hazptr/openrb-pico-hw/kicad/reference/render/openrb_rev0.2_bottom.png

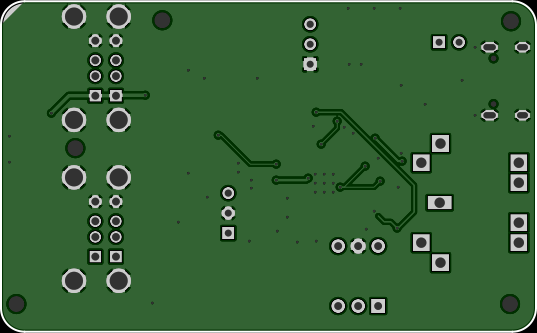
kicad/reference/render/openrb_rev0.2_bottom.png
