hazptr/openrb-pico-hw/kicad/reference/render/openrb_rev0.2_top.png

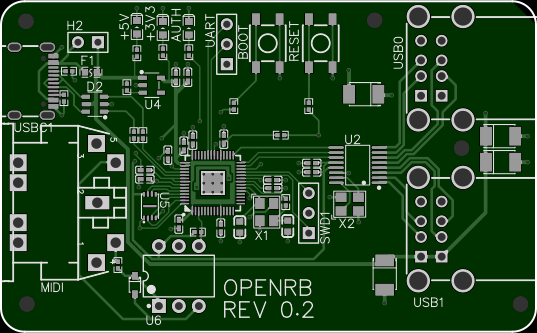
kicad/reference/render/openrb_rev0.2_top.png
