hazptr/openrb-pico-hw/recovered-artifacts/openrb_rev0.2_BOM.csv

ID | Name | Designator | Footprint | Quantity | Manufacturer Part | Manufacturer | Supplier | Supplier Part | Price | Contributor | 3DModel | link | JLCPCB Part Class | Package Display | image | subpart_no
1 | LED-0603_R | +3V3,+5V,AUTH | LED0603_RED | 3 | 19-217/R6C-AL1M2VY/3T | EVERLIGHT(台湾亿光) | LCSC | C72044 |  | LCEDA_01 | LED0603_Red
2 | PTS647SM38SMTR2LFS | BOOT,RESET | KEY-SMD_4P-L4.5-W4.5-P3.00-LS6.5-TL | 2 | PTS647SM38SMTR2LFS | C&K | LCSC | C2689502 |  | LCSC | KEY-SMD_4P-L4.5-W4.5-P3.00-LS6.5-TL | https://item.szlcsc.com/532641.html?ref=editor&logined=true | Extended Part
3 | 10uF | C1,C2 | C0402 | 2 | GRM155R61A106ME44D | muRata(村田) | LCSC | C77000 |  | lcsc | C0402_L1.0-W0.5-H0.5 | https://item.szlcsc.com/15869.html | Extended Part
4 | 100nF | C3,C4,C5,C6,C8,C9,C10,C11 | C0402 | 8 | CL05B104KB54PNC | SAMSUNG(三星) | LCSC | C307331 |  | LCSC | C0402_L1.0-W0.5-H0.5 | https://item.szlcsc.com/15869.html | Basic Part
5 | 1uF | C7,C18 | C0402 | 2 |  |  | LCSC | C107372 |  | lcsc | C0402_L1.0-W0.5-H0.5 | https://item.szlcsc.com/15869.html | Extended Part | No
6 | 100uF | C12,C13,C14,C17 | CASE-B_3528 | 4 | TAJB107K006RNJ | Kyocera AVX | LCSC | C16133 |  | lcsc | CASE-B_L3.5-W2.8-H1.9 | https://img.jlc.com/pdf/applyPasteComponent/2021-05-29/507681S/b3196547ade04cd291a1b09ea1ee2ece/C7199_22UF.PDF | Basic Part
7 | 15pF | C15,C16 | C0603 | 2 | CL10C150JB8NNNC |  | LCSC | C1644 |  | lcsc | C0603_L1.6-W0.8-H0.8 | https://item.szlcsc.com/362304.html | Extended Part | No
8 | 1uF | C19,C20 | C0402 | 2 |  |  | LCSC | C107372 |  | lcsc | C0402_L1.0-W0.5-H0.5 | https://item.szlcsc.com/15869.html |  | No
9 | 1N4148WS_C402214 | D1 | SOD-323_L1.8-W1.3-LS2.5-RD | 1 | 1N4148WS | LGE(鲁光) | LCSC | C402214 |  | LCSC | SOD-323_L1.7-W1.3-H1.1-LS2.5 | https://item.szlcsc.com/295156.html | Extended Part
10 | USBLC6-2SC6_C2827654 | D2 | SOT-23-6_L2.9-W1.6-P0.95-LS2.8-BL | 1 | USBLC6-2SC6 | TECH PUBLIC(台舟) | LCSC | C2827654 |  | LCSC | SOT-23-6_L2.9-W1.6-H1.5-LS2.8-P0.95 | https://item.szlcsc.com/169042.html | Extended Part
11 | ASMD0603-020 | F1 | F0603 | 1 | ASMD0603-020 | JDTfuse(集电通) | LCSC | C135321 |  | LCSC | F0603_L1.7-W0.9-H0.7 | https://item.szlcsc.com/208133.html | Extended Part
12 | HDR-F-2.54_1x2 | H2 | HDR-F-2.54_1X2 | 1 |  |  | LCSC | C49661 |  | LCEDA_Lib | HDR-F-2.54_1x2
13 | MIDIJACK | MIDI | CP-2350 | 1 |  |  |  |  |  | Adafruit |  |  |  |  |  | 3
14 | 5.1kΩ | R1 | R0402 | 1 |  |  | LCSC |  |  | lcsc | R0402_L1.0-W0.5-H0.5 | https://item.szlcsc.com/323315.html | Extended Part
15 | 220Ω | R2 | R0402 | 1 |  |  | LCSC | C25091 |  | lcsc | R0402_L1.0-W0.5-H0.5 | https://item.szlcsc.com/323315.html | Extended Part | No
16 | 5.1kΩ | R3 | R0402 | 1 |  |  |  |  |  | lcsc | R0402_L1.0-W0.5-H0.5 | https://item.szlcsc.com/323315.html | Extended Part
17 | 470Ω | R4 | R0402 | 1 | RC0402JR-07470RL | YAGEO(国巨) | LCSC | C114949 |  | lcsc | R0402_L1.0-W0.5-H0.5 | https://item.szlcsc.com/323315.html | Extended Part
18 | 470Ω | R6,R8 | R0402 | 2 |  |  |  |  |  | LCEDA_Lib | R0402_L1.0-W0.5-H0.5 | https://item.szlcsc.com/323315.html |  | No
19 | 10kΩ | R9 | R0402 | 1 |  |  |  |  |  | lcsc | R0402_L1.0-W0.5-H0.5 | https://item.szlcsc.com/323315.html | Extended Part | No
20 | 1kΩ | R10 | R0402 | 1 | RC0402JR-071KL | YAGEO(国巨) | LCSC | C105637 |  | lcsc | R0402_L1.0-W0.5-H0.5 | https://item.szlcsc.com/323315.html | Extended Part
21 | 1kΩ | R7,R11,R12 | R0402 | 3 |  |  |  |  |  | LCEDA_Lib | R0402_L1.0-W0.5-H0.5 | https://item.szlcsc.com/323315.html
22 | 10kΩ | R13 | R0402 | 1 |  |  |  |  |  | LCEDA_Lib | R0402_L1.0-W0.5-H0.5 | https://item.szlcsc.com/323315.html
23 | 22Ω | R14,R15 | R0402 | 2 |  |  |  |  |  | LCEDA_Lib | R0402_L1.0-W0.5-H0.5 | https://item.szlcsc.com/323315.html
24 | HDR-F-2.54_1x3 | SWD1,UART | HDR-F-2.54_1X3 | 2 |  |  | LCSC | C146690 |  | LCEDA_Lib | HDR-F-2.54_1x3 | https://www.cjt.com/Upload/A2541.pdf
25 | RP2040 | U1 | LQFN-56_L7.0-W7.0-P0.4-EP | 1 | RP2040 | Raspberry Pi(树莓派) | LCSC | C2040 |  | LCSC | LQFN-56_L7.0-W7.0-P0.4-EP | https://atta.szlcsc.com/upload/public/pdf/source/20210621/C2040_96F425825606B7957D87DD32E2512CA9.pdf | Extended Part
26 | CH334R | U2 | QSOP-16_L4.9-W3.9-P0.64-LS6.0-BL | 1 | CH334R | WCH(南京沁恒) | LCSC | C4154405 |  | lcsc | QSOP-16_L4.9-W3.9-H1.6-LS6.0-P0.64 | https://item.szlcsc.com/216411.html | Extended Part
27 | RT9080-33GJ5 | U4 | TSOT-23-5_L2.9-W1.6-P0.95-LS2.8-BL | 1 | RT9080-33GJ5 | RICHTEK(立锜) | LCSC | C841192 |  | LCSC | TSOT-23-5_L2.9-W1.6-H1.00-LS2.8-P0.95 | https://item.szlcsc.com/233411.html | Extended Part
28 | W25Q16JVUXIQ | U5 | USON-8_L3.0-W2.0-P0.50-BL-EP | 1 | W25Q16JVUXIQ | WINBOND(华邦) | LCSC | C2843335 |  | lcsc | USON-8_L2-W3-H0.6X0.5P | https://item.szlcsc.com/355847.html | Extended Part
29 | H11L1 | U6 | DIP-6_L8.5-W6.4-P2.54-LS7.6-BL | 1 | H11L1 | EVERLIGHT(亿光) | LCSC | C78588 |  | lcsc | DIP-6_L7.3-W6.5-H3.5-LS7.62-P2.54 | https://item.szlcsc.com/195665.html | Extended Part
30 | UB1112C-8FDE-4F | USB0,USB1 | USB-A-TH_UB1112C-8FDE-4F | 2 | UB1112C-8FDE-4F | FOXCONN(富士康) | LCSC | C2761534 |  | LCSC | USB-A-TH_UB1112C-8FDE-4F | https://item.szlcsc.com/2885963.html | Extended Part
31 | TYPE-C-31-M-12 | USBC1 | USB-C_SMD-TYPE-C-31-M-12 | 1 | TYPE-C-31-M-12 | 韩国韩荣 | LCSC | C165948 |  | LCSC | USB-C_SMD-TYPE-C-31-M-12 | https://so.szlcsc.com/global.html?c=&k=C165948 | Extended Part
32 | 12MHz | X1,X2 | OSC-SMD_4P-L3.2-W2.5-BL | 2 | X322512MSB4SI | YXC(扬兴晶振) | LCSC | C9002 |  | lcsc | OSC-SMD_4P-L3.2-W2.5-H1.0 | https://item.szlcsc.com/15866.html | Basic Part
