hazptr/openrb-pico-hw/kicad/openrb/openrb_schematic.pdf

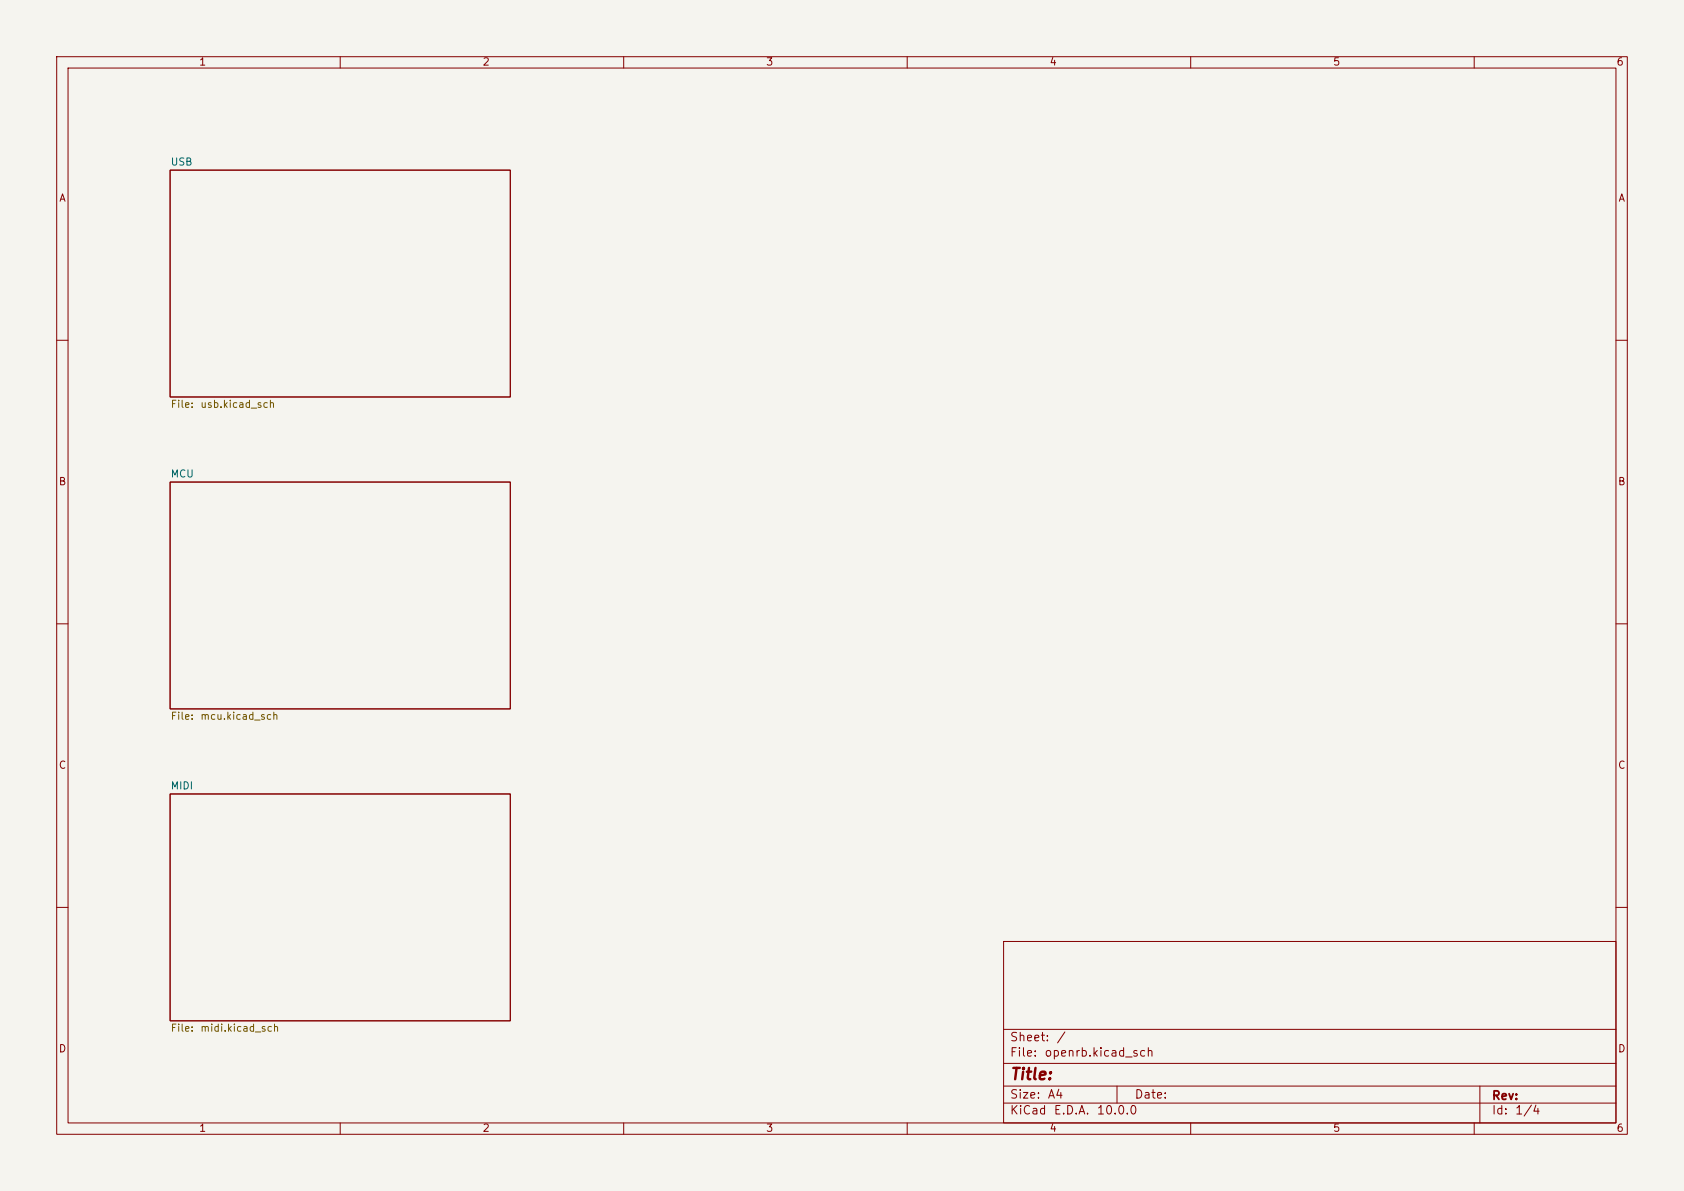
[picture p3: page 1]

File: mcu.kicad_sch MIDI File: midi.kicad_sch

Size: A4 | Rev:
KiCad E.D.A. 10.0.0 | Id: 1/4

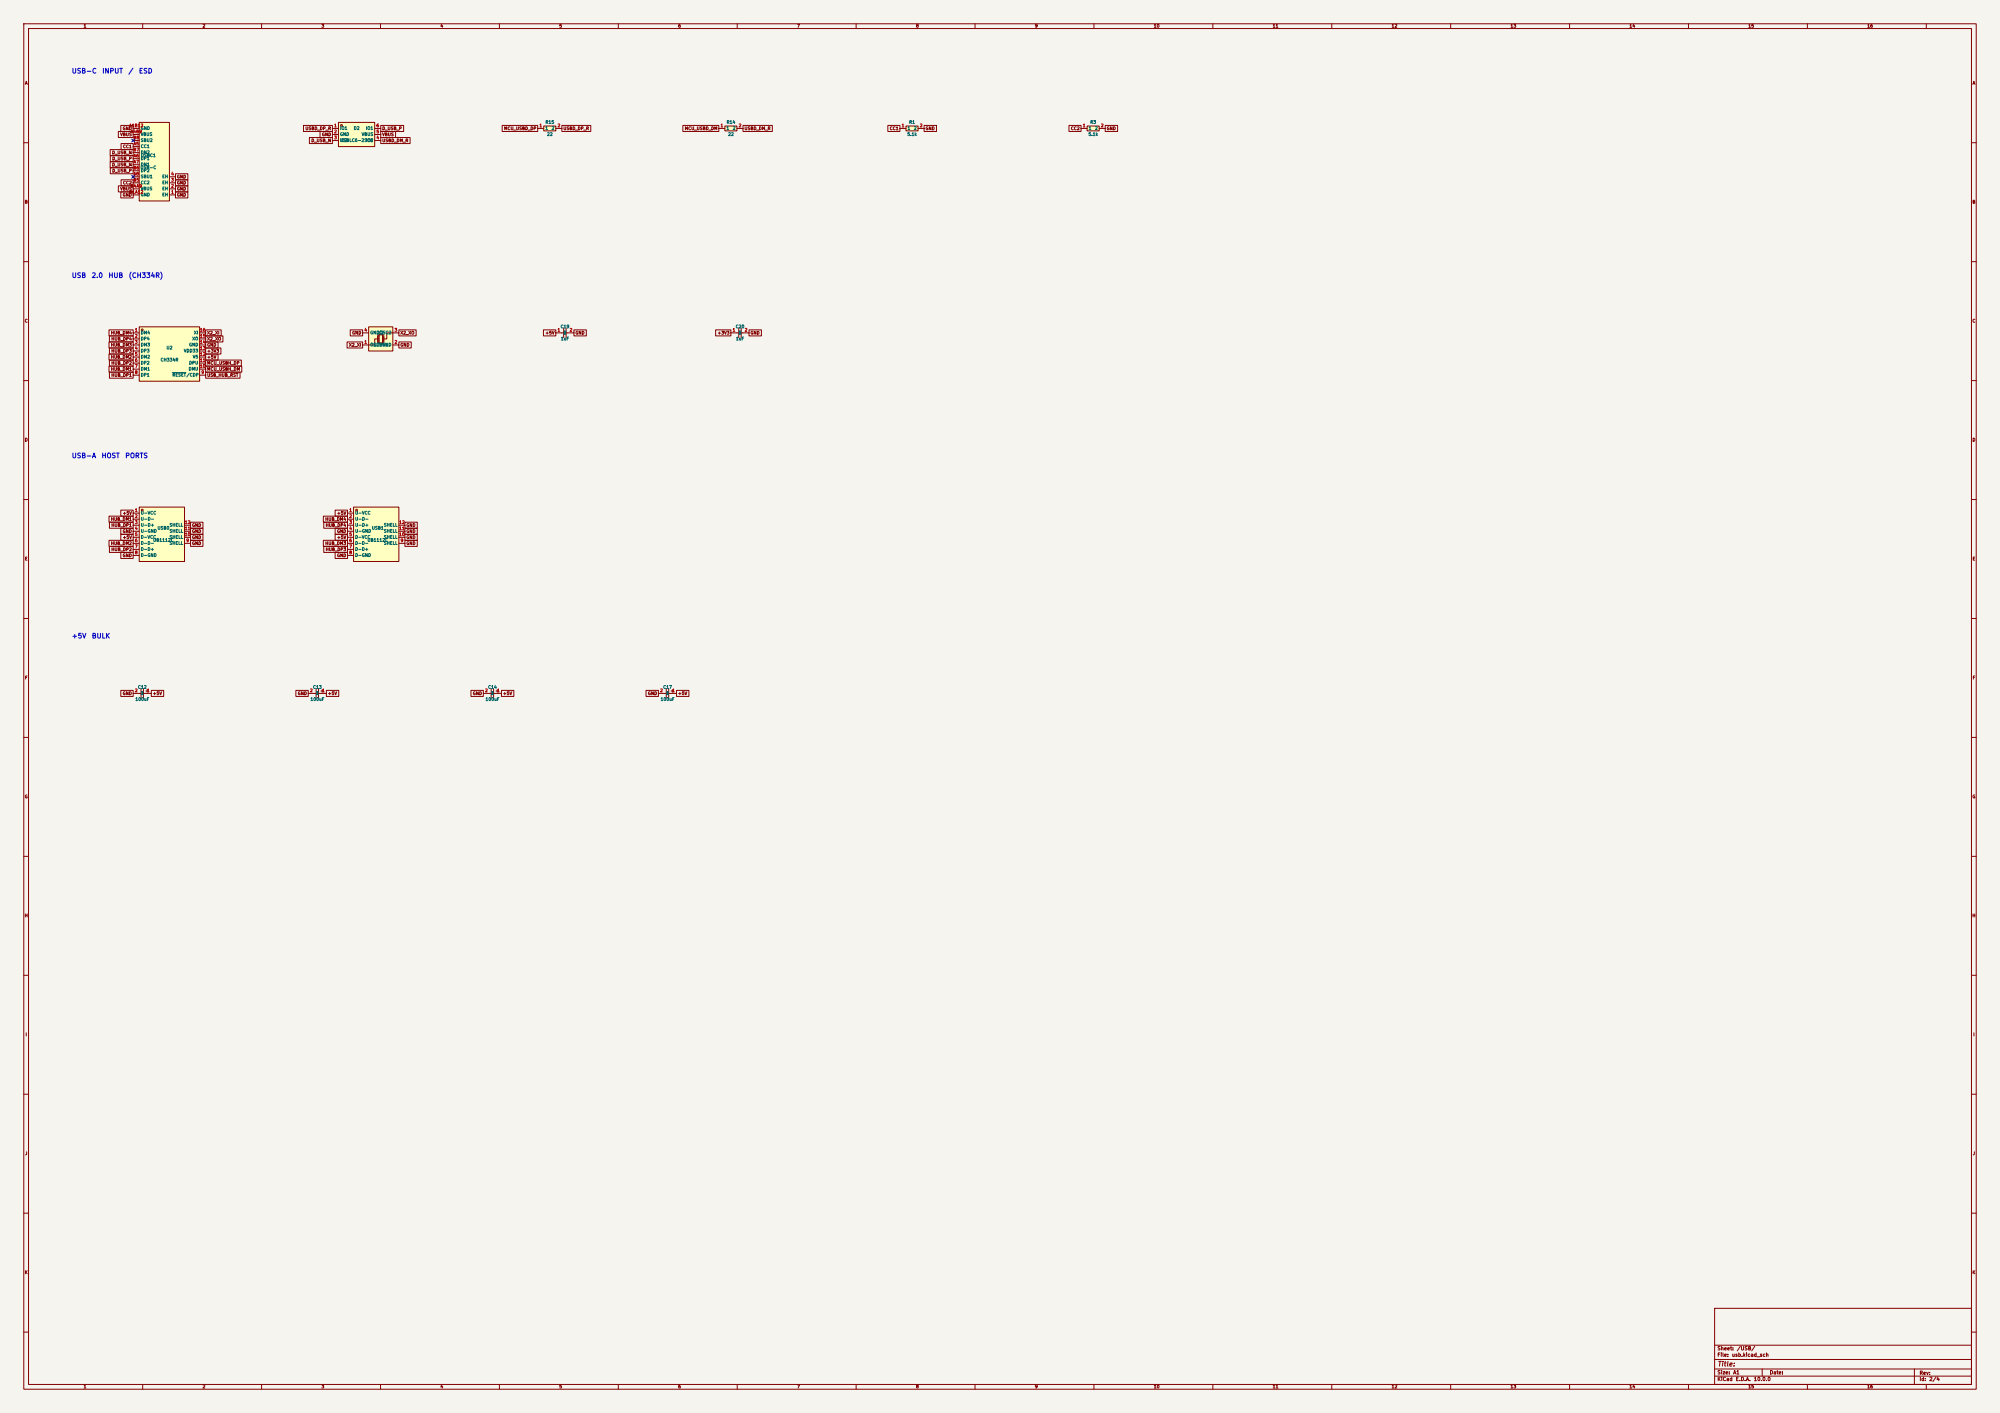
[picture p4: page 2]

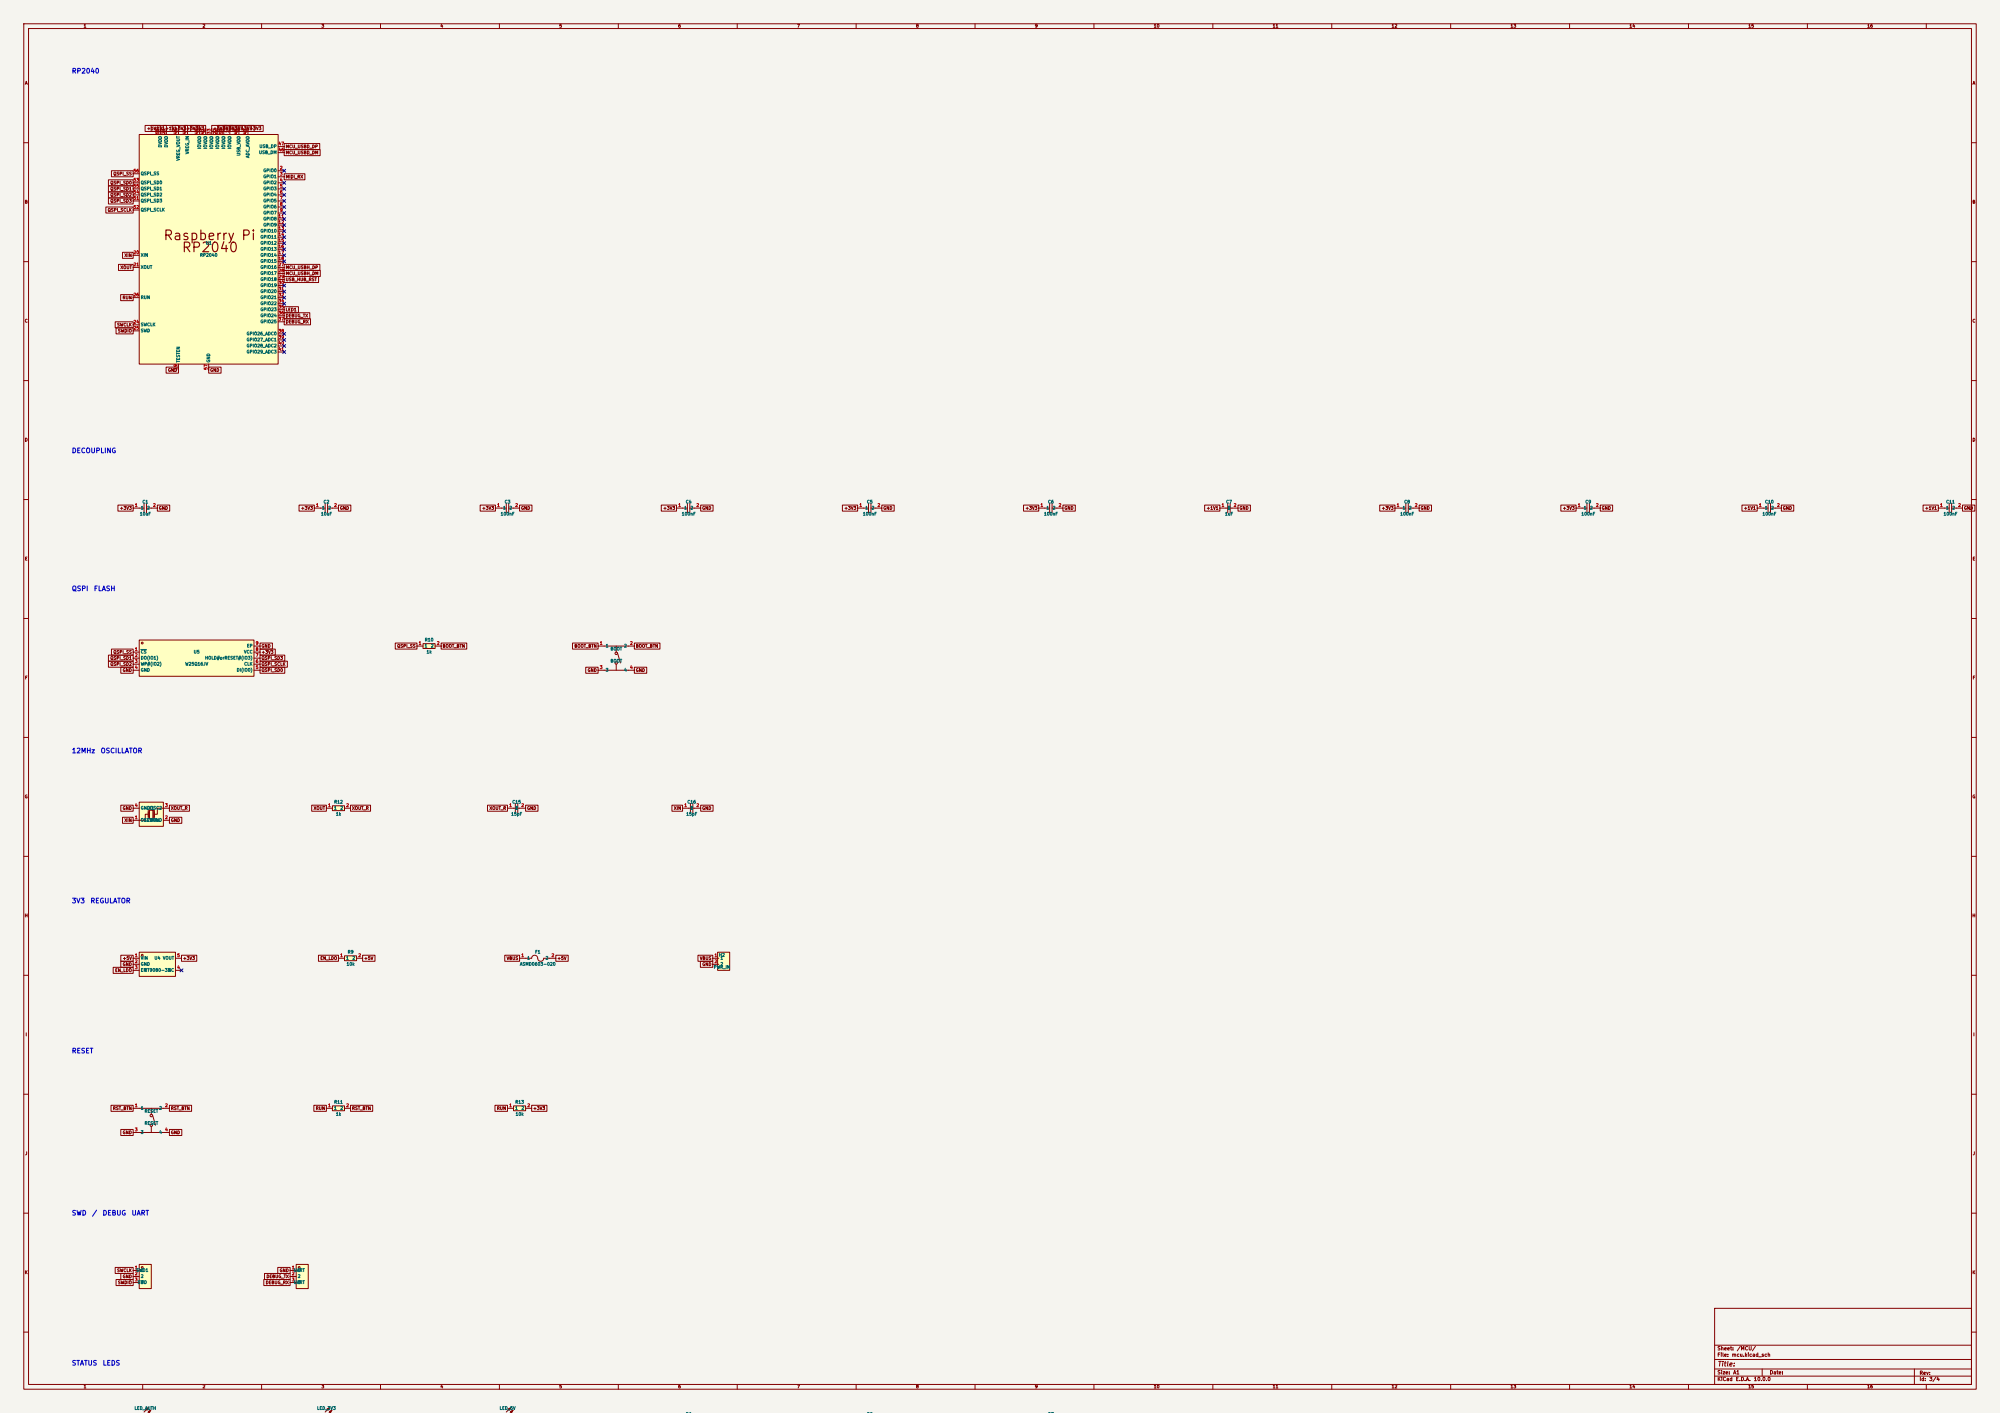
[picture p5: page 3]

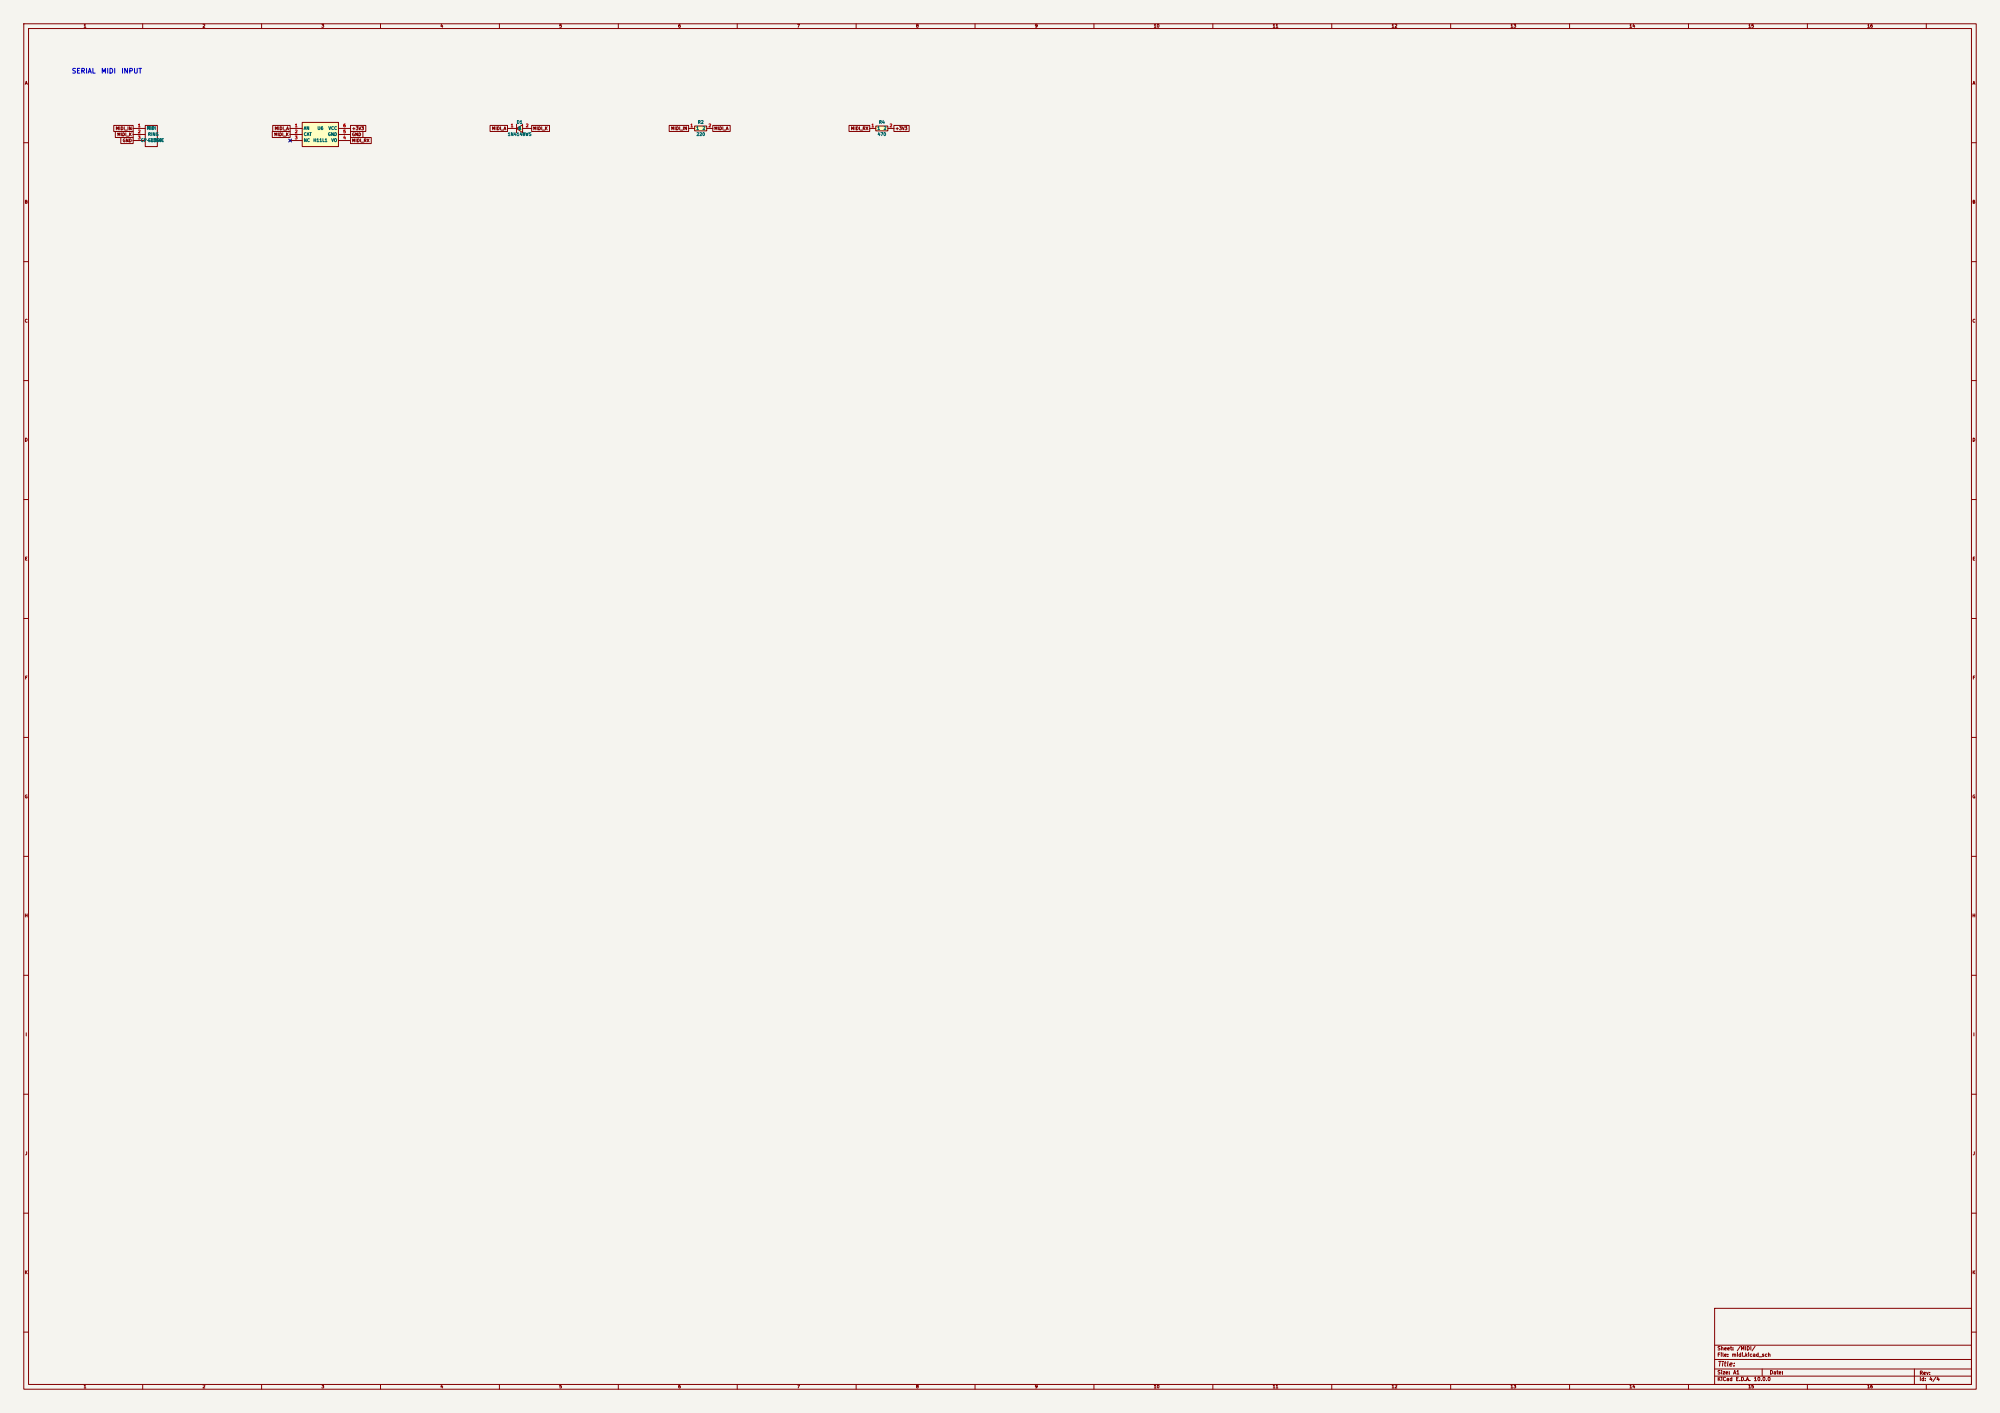
[picture p6: page 4]
