hazptr/openrb-pico-hw/recovered-artifacts/Schematic_OpenRB_2024-11-02.pdf

# USB C

# USB HOST

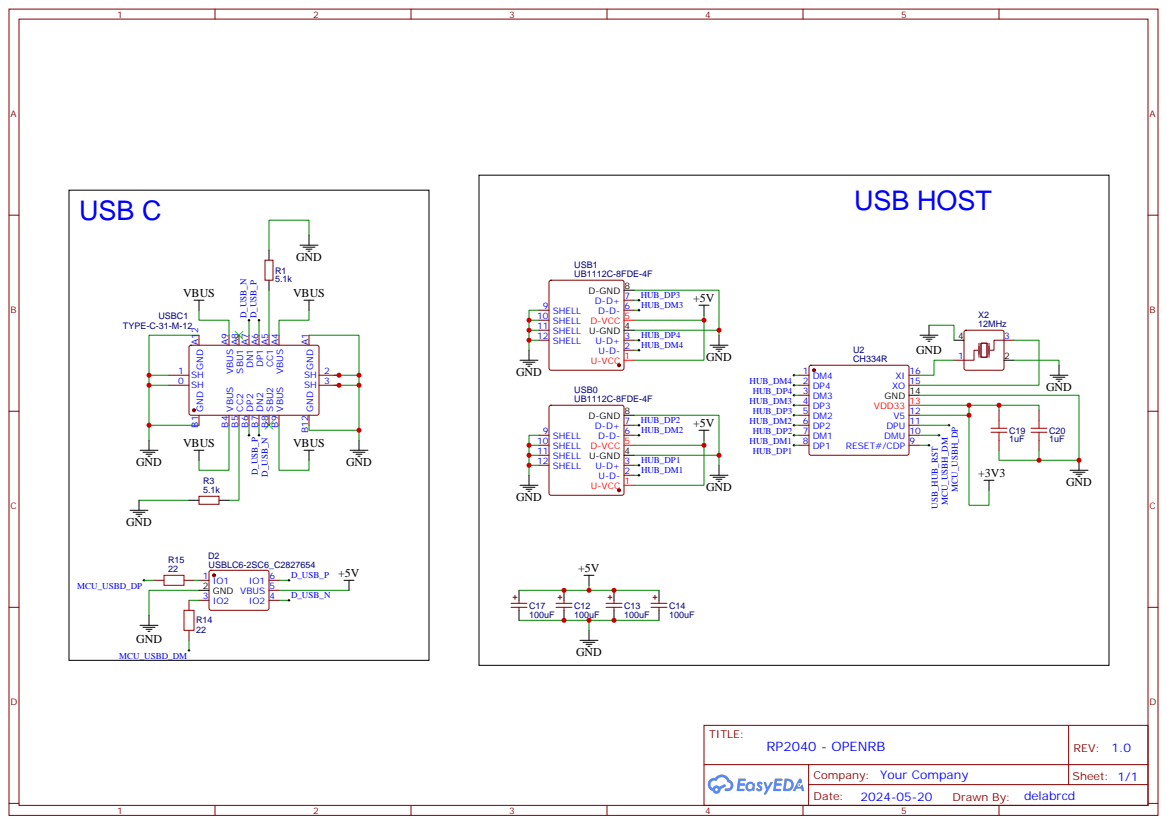
[picture p7: page 1]

UC

# OSC

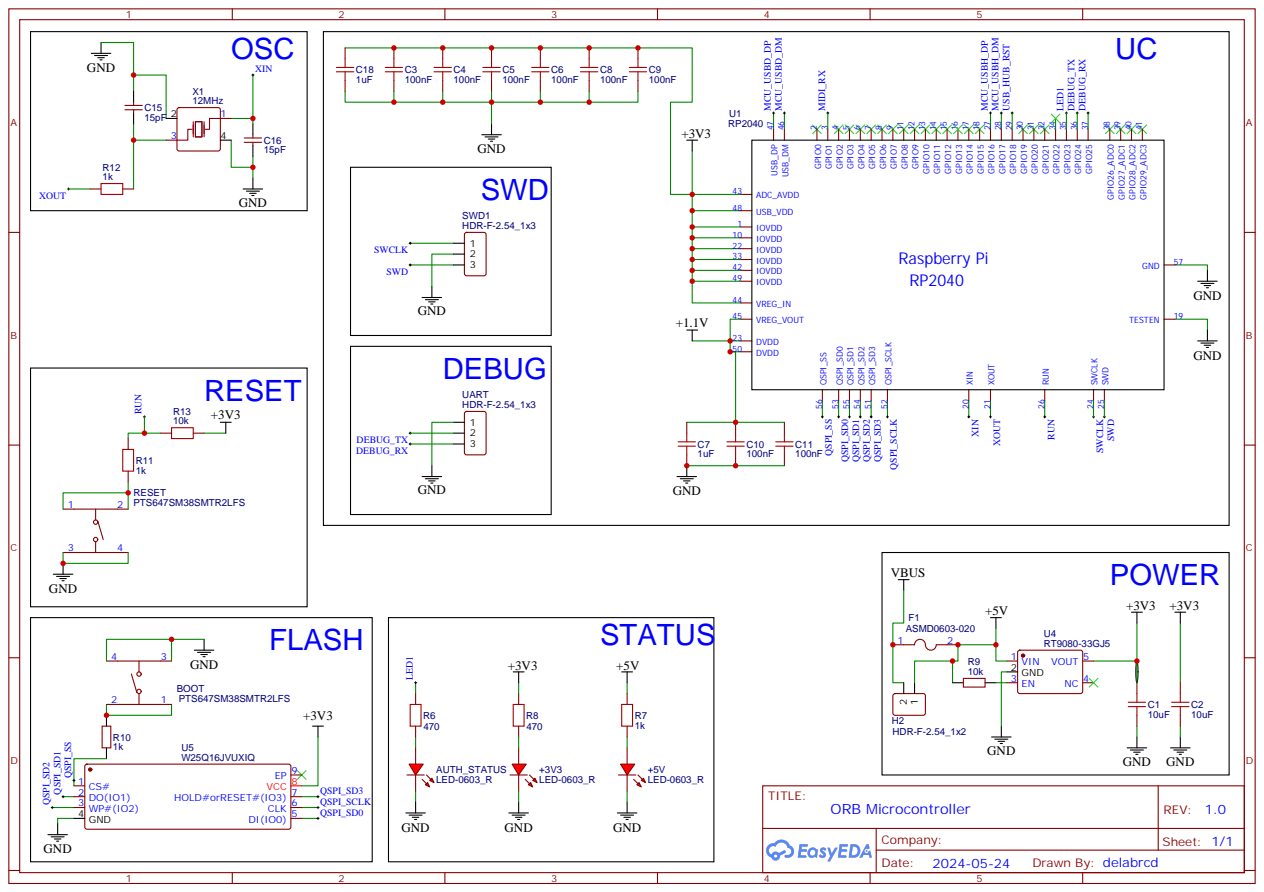
[picture p8: page 2]

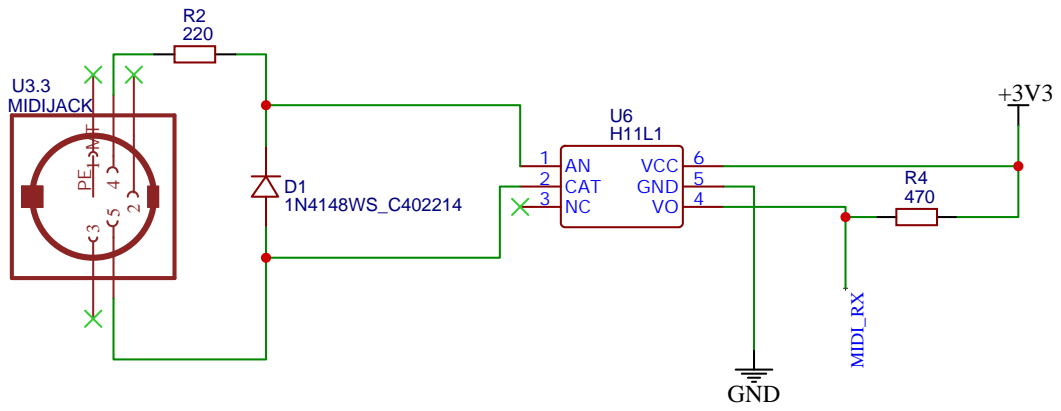
[picture p9: page 3]
