hazptr/openrb-pico-hw/kicad/openrb/mcu.kicad_sch

## KiCad design kicad/openrb/mcu.kicad_sch (2026-06-25)

Schematic: mcu.kicad_sch

Parts:
BOOT: BOOT; KEY-SMD_4P-L4.5-W4.5-P3.00-LS6.5-TL
C1, C2: 10uF; C0402
C3, C4, C5, C6, C8, C9, C10, C11: 100nF; C0402
C7, C18: 1uF; C0402
C15, C16: 15pF; C0603
F1: ASMD0603-020; F0603
H2: PWR_IN; HDR-TH_2P-P2.54-V-F
LED_3V3: 3V3; LED0603-RD
LED_5V: 5V; LED0603-RD
LED_AUTH: AUTH; LED0603-RD
R6, R8: 470; R0402
R7, R10, R11, R12: 1k; R0402
R9, R13: 10k; R0402
RESET: RESET; KEY-SMD_4P-L4.5-W4.5-P3.00-LS6.5-TL
SWD1: SWD; HDR-TH_3P-P2.54-V-F
U1: RP2040; LQFN-56_L7.0-W7.0-P0.4-EP
U4: RT9080-33; TSOT-23-5_L2.9-W1.6-P0.95-LS2.8-BL
U5: W25Q16JV; USON-8_L3.0-W2.0-P0.50-BL-EP
UART: UART; HDR-TH_3P-P2.54-V-F
X1: 12MHz; CRYSTAL-SMD_4P-L3.2-W2.5-BL

Connections:
+1V1: C7.1, C10.1, C11.1, U1.23 (DVDD), U1.45 (VREG_VOUT), U1.50 (DVDD)
+3V3: C1.1, C2.1, C3.1, C4.1, C5.1, C6.1, C8.1, C9.1, C18.1, R8.1, R13.2, U1.1 (IOVDD), U1.10 (IOVDD), U1.22 (IOVDD), U1.33 (IOVDD), U1.42 (IOVDD), U1.43 (ADC_AVDD), U1.44 (VREG_IN), U1.48 (USB_VDD), U1.49 (IOVDD), U4.5 (VOUT), U5.8 (VCC)
+5V: F1.2, R7.1, R9.2, U4.1 (VIN)
BOOT_BTN: BOOT.1, BOOT.2, R10.2
DEBUG_RX: U1.37 (GPIO25), UART.3
DEBUG_TX: U1.36 (GPIO24), UART.2
EN_LDO: R9.1, U4.3 (EN)
GND: BOOT.3, BOOT.4, C1.2, C2.2, C3.2, C4.2, C5.2, C6.2, C7.2, C8.2, C9.2, C10.2, C11.2, C15.2, C16.2, C18.2, H2.2, LED_3V3.1 (C), LED_5V.1 (C), LED_AUTH.1 (C), RESET.3, RESET.4, SWD1.2, U1.19 (TESTEN), U1.57 (GND), U4.2 (GND), U5.4 (GND), U5.9 (EP), UART.1, X1.2 (GND), X1.4 (GND)
LED1: R6.1, U1.35 (GPIO23)
MCU_USBD_DM: U1.46 (USB_DM)
MCU_USBD_DP: U1.47 (USB_DP)
MCU_USBH_DM: U1.28 (GPIO17)
MCU_USBH_DP: U1.27 (GPIO16)
MIDI_RX: U1.3 (GPIO1)
N_3V3LED: LED_3V3.2 (A), R8.2
N_5VLED: LED_5V.2 (A), R7.2
N_AUTH: LED_AUTH.2 (A), R6.2
QSPI_SCLK: U1.52 (QSPI_SCLK), U5.6 (CLK)
QSPI_SD0: U1.53 (QSPI_SD0), U5.5 (DI(IO0))
QSPI_SD1: U1.55 (QSPI_SD1), U5.2 (DO(IO1))
QSPI_SD2: U1.54 (QSPI_SD2), U5.3 (WP#(IO2))
QSPI_SD3: U1.51 (QSPI_SD3), U5.7 (HOLD#orRESET#(IO3))
QSPI_SS: R10.1, U1.56 (QSPI_SS), U5.1 (~CS)
RST_BTN: R11.2, RESET.1, RESET.2
RUN: R11.1, R13.1, U1.26 (RUN)
SWCLK: SWD1.1, U1.24 (SWCLK)
SWDIO: SWD1.3, U1.25 (SWD)
USB_HUB_RST: U1.29 (GPIO18)
VBUS: F1.1, H2.1
XIN: C16.1, U1.20 (XIN), X1.1 (OSC1)
XOUT: R12.1, U1.21 (XOUT)
XOUT_R: C15.1, R12.2, X1.3 (OSC2)

Notes on the sheet:
RP2040
DECOUPLING
QSPI FLASH
12MHz OSCILLATOR
3V3 REGULATOR
RESET
SWD / DEBUG UART
STATUS LEDS
