hazptr/openrb-pico-hw/kicad/openrb/midi.kicad_sch

## KiCad design kicad/openrb/midi.kicad_sch (2026-06-25)

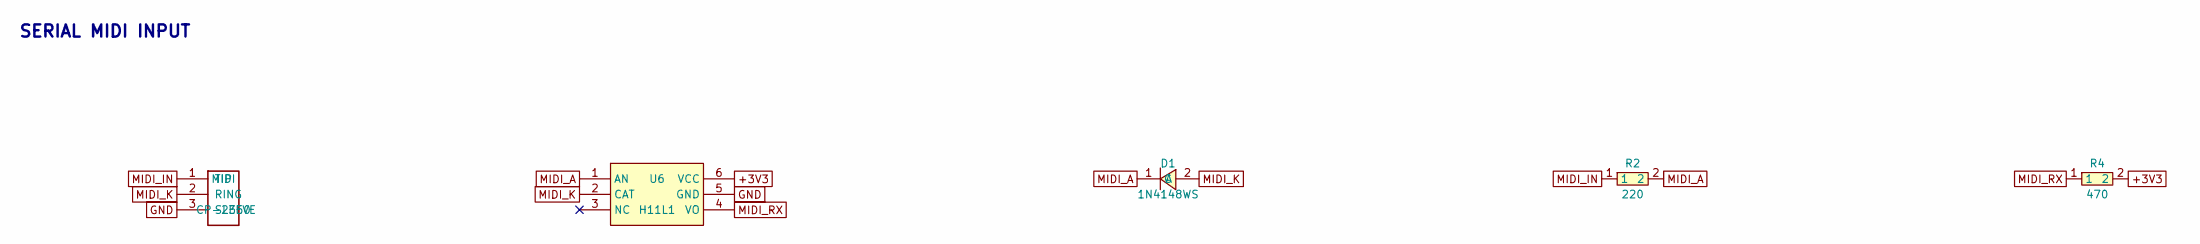
[picture p10: schematic midi.kicad_sch]

Parts:
D1: 1N4148WS; SOD-323_L1.8-W1.3-LS2.5-RD
MIDI: CP-2350
R2: 220; R0402
R4: 470; R0402
U6: H11L1; DIP-6_L8.5-W6.4-P2.54-LS7.6-BL

Connections:
+3V3: R4.2, U6.6 (VCC)
GND: MIDI.3 (SLEEVE), U6.5 (GND)
MIDI_A: D1.1 (C), R2.2, U6.1 (AN)
MIDI_IN: MIDI.1 (TIP), R2.1
MIDI_K: D1.2 (A), MIDI.2 (RING), U6.2 (CAT)
MIDI_RX: R4.1, U6.4 (VO)

Notes on the sheet:
SERIAL MIDI INPUT
