hazptr/openrb-pico-hw/kicad/openrb/usb.kicad_sch

## KiCad design kicad/openrb/usb.kicad_sch (2026-06-25)

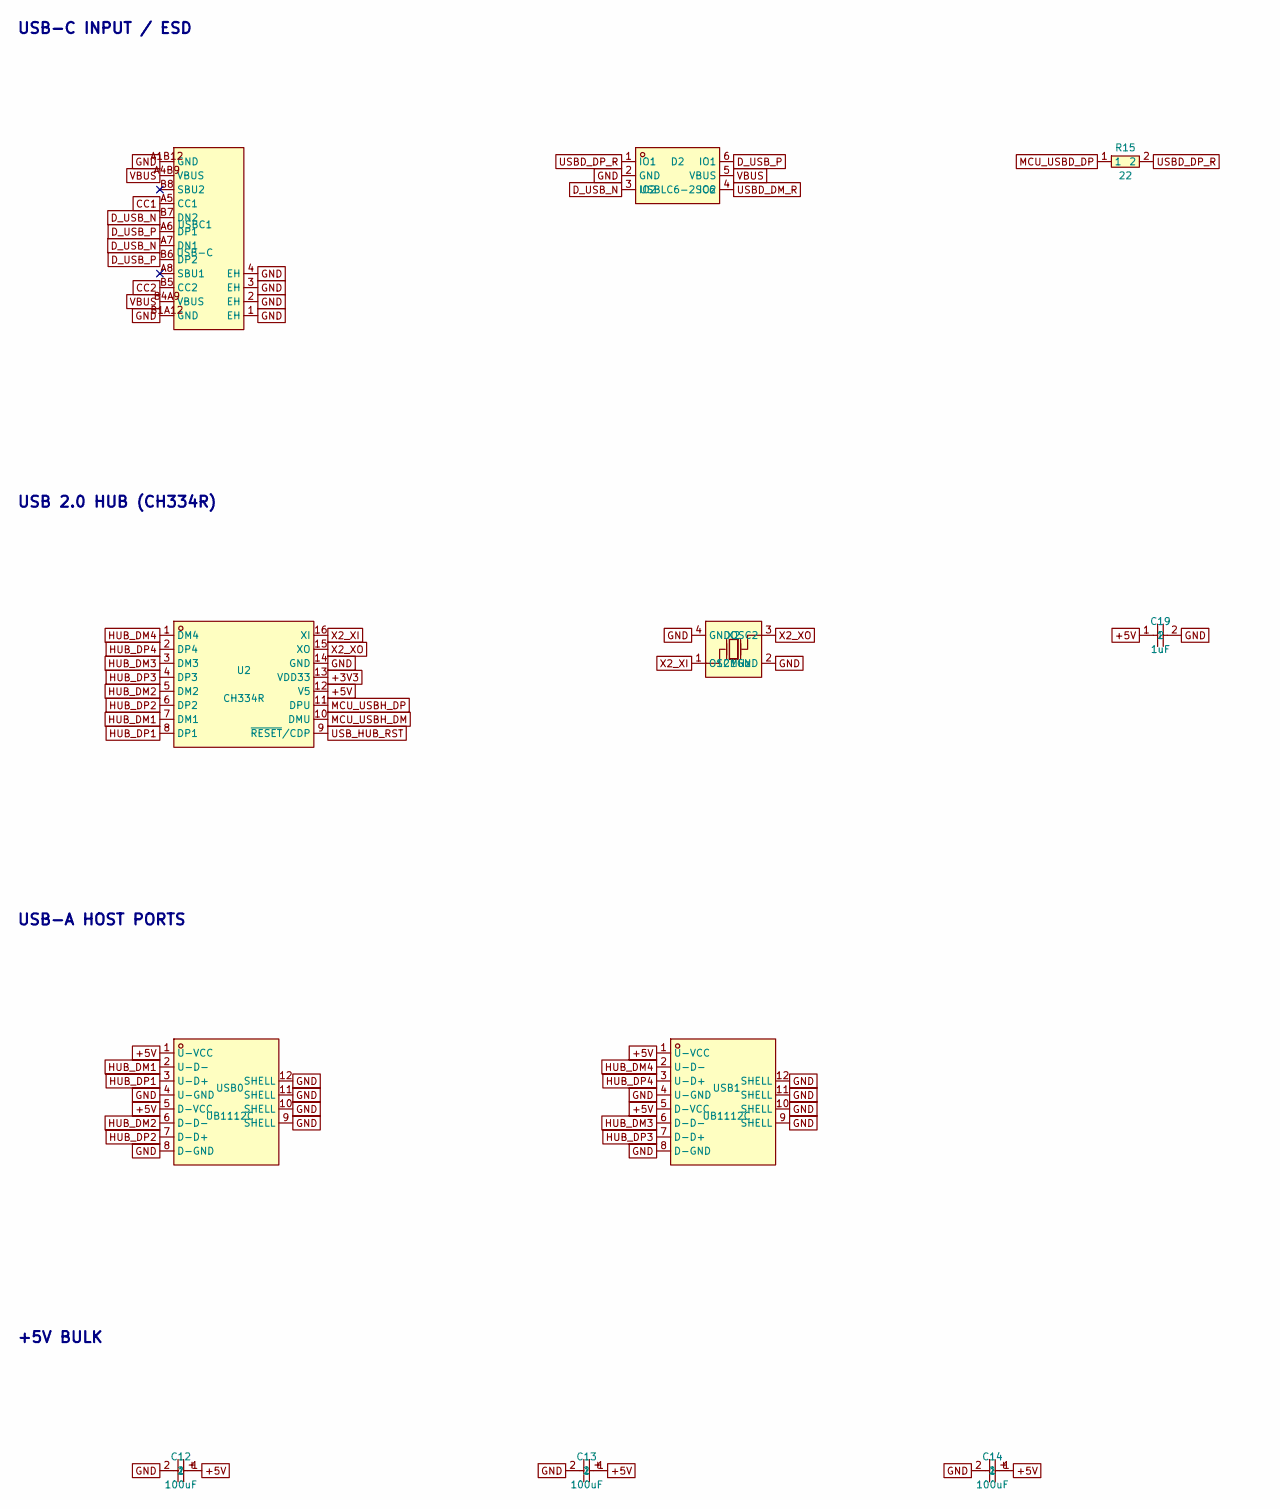
[picture p11: schematic usb.kicad_sch, part in row 1, column 1]

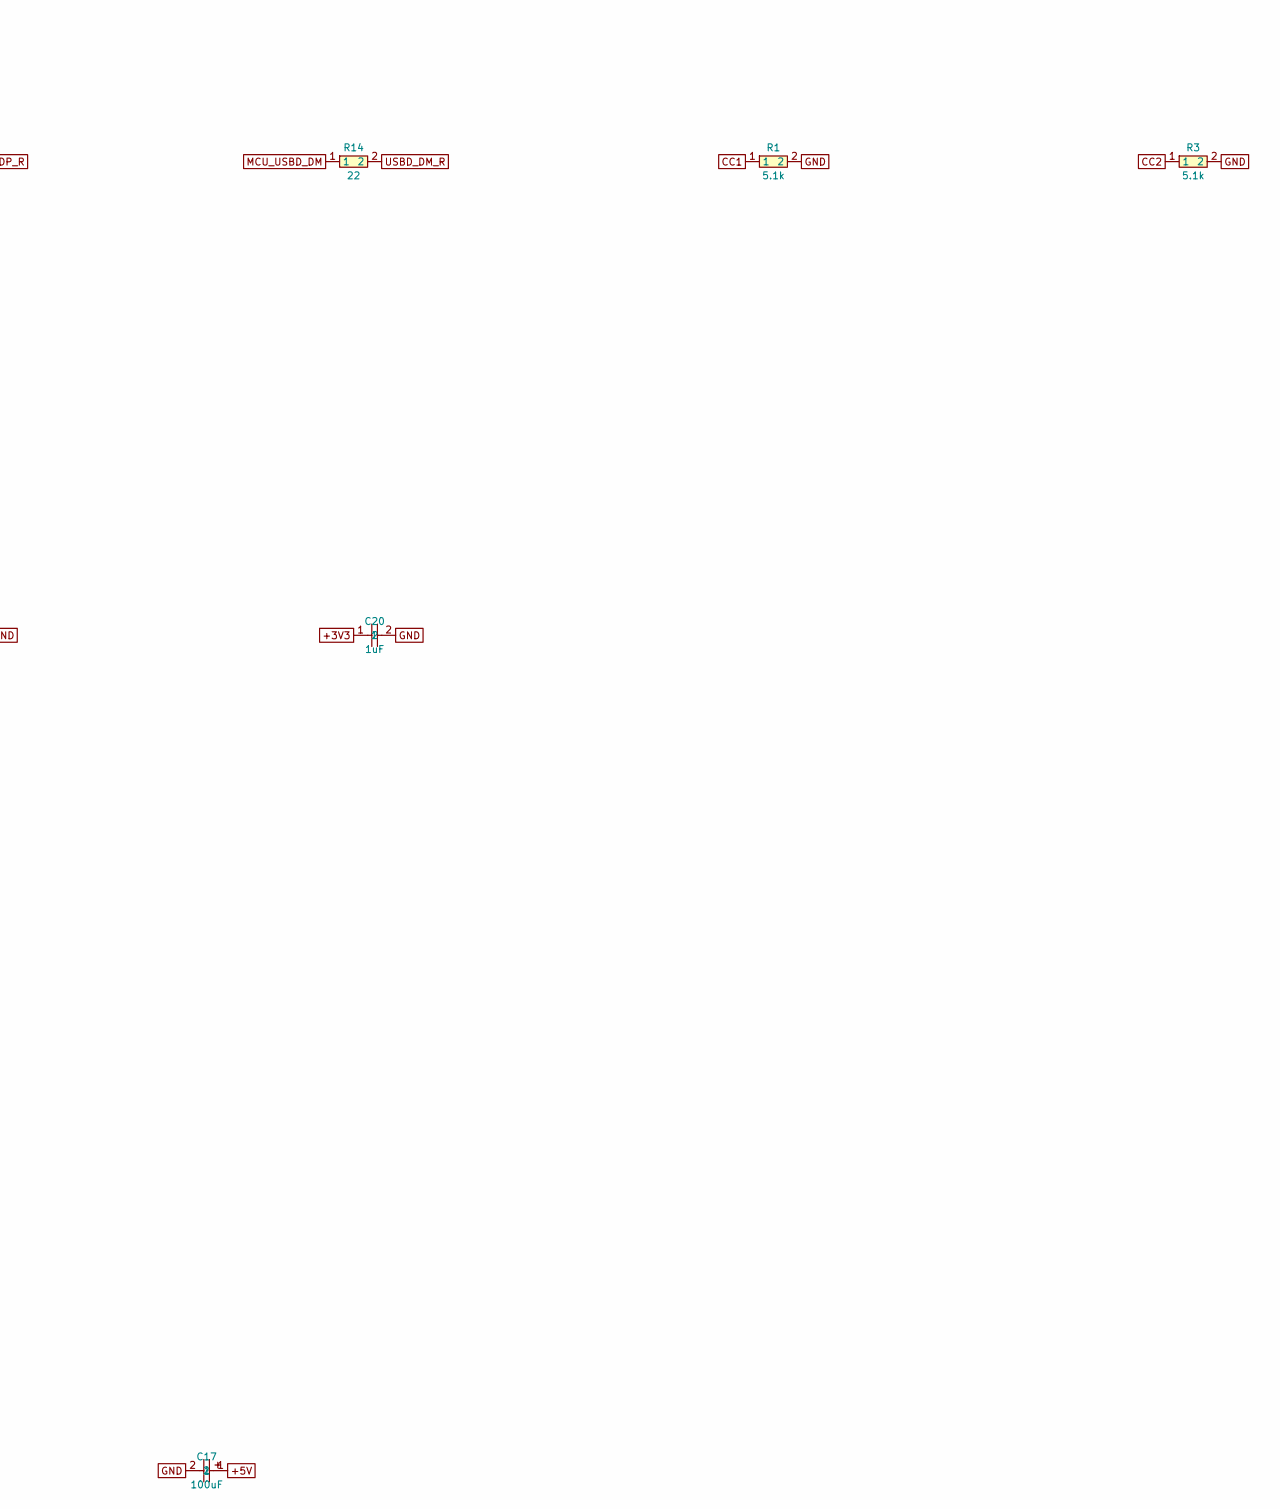
[picture p12: schematic usb.kicad_sch, part in row 1, column 2]

Parts:
C12, C13, C14, C17: 100uF; CASE-B_3528
C19, C20: 1uF; C0402
D2: USBLC6-2SC6; SOT-23-6_L2.9-W1.6-P0.95-LS2.8-BL
R1, R3: 5.1k; R0402
R14, R15: 22; R0402
U2: CH334R; QSOP-16_L4.9-W3.9-P0.64-LS6.0-BL
USB0, USB1: UB1112C; USB-A-TH_UB1112C-8FDE-4F
USBC1: USB-C; USB-C_SMD-TYPE-C-31-M-12_1
X2: 12MHz; CRYSTAL-SMD_4P-L3.2-W2.5-BL

Connections:
+3V3: C20.1, U2.13 (VDD33)
+5V: C12.1, C13.1, C14.1, C17.1, C19.1, U2.12 (V5), USB0.1 (U-VCC), USB0.5 (D-VCC), USB1.1 (U-VCC), USB1.5 (D-VCC)
CC1: R1.1, USBC1.A5 (CC1)
CC2: R3.1, USBC1.B5 (CC2)
D_USB_N: D2.3 (IO2), USBC1.A7 (DN1), USBC1.B7 (DN2)
D_USB_P: D2.6 (IO1), USBC1.A6 (DP1), USBC1.B6 (DP2)
GND: C12.2, C13.2, C14.2, C17.2, C19.2, C20.2, D2.2 (GND), R1.2, R3.2, U2.14 (GND), USB0.4 (U-GND), USB0.8 (D-GND), USB0.9 (SHELL), USB0.10 (SHELL), USB0.11 (SHELL), USB0.12 (SHELL), USB1.4 (U-GND), USB1.8 (D-GND), USB1.9 (SHELL), USB1.10 (SHELL), USB1.11 (SHELL), USB1.12 (SHELL), USBC1.1 (EH), USBC1.2 (EH), USBC1.3 (EH), USBC1.4 (EH), USBC1.A1B12 (GND), USBC1.B1A12 (GND), X2.2 (GND), X2.4 (GND)
HUB_DM1: U2.7 (DM1), USB0.2 (U-D-)
HUB_DM2: U2.5 (DM2), USB0.6 (D-D-)
HUB_DM3: U2.3 (DM3), USB1.6 (D-D-)
HUB_DM4: U2.1 (DM4), USB1.2 (U-D-)
HUB_DP1: U2.8 (DP1), USB0.3 (U-D+)
HUB_DP2: U2.6 (DP2), USB0.7 (D-D+)
HUB_DP3: U2.4 (DP3), USB1.7 (D-D+)
HUB_DP4: U2.2 (DP4), USB1.3 (U-D+)
MCU_USBD_DM: R14.1
MCU_USBD_DP: R15.1
MCU_USBH_DM: U2.10 (DMU)
MCU_USBH_DP: U2.11 (DPU)
USBD_DM_R: D2.4 (IO2), R14.2
USBD_DP_R: D2.1 (IO1), R15.2
USB_HUB_RST: U2.9 (~RESET/CDP)
VBUS: D2.5 (VBUS), USBC1.A4B9 (VBUS), USBC1.B4A9 (VBUS)
X2_XI: U2.16 (XI), X2.1 (OSC1)
X2_XO: U2.15 (XO), X2.3 (OSC2)

Notes on the sheet:
USB-C INPUT / ESD
USB 2.0 HUB (CH334R)
USB-A HOST PORTS
+5V BULK
