hazptr/openrb-pico-hw/(commit log)

2026-06-25 Recover OpenRB rev 0.2 source artifacts + reconstruction spec
    The editable EasyEDA design was lost; only outputs survived. Preserve the
    surviving artifacts (schematic PDF, BOM, Gerbers, JLC package) in-repo and
    add RECONSTRUCTION.md: an authoritative part table + netlist derived from the
    PDF, BOM, and firmware pin map, as the spec for rebuilding an editable KiCad
    project.
2026-06-25 Verify reconstruction netlist against high-res schematic render
    All previously-uncertain nets confirmed from the PDF + board-owner answers:
    device-side 22R (R14/R15), GPIO18 wired to USB_HUB_RST (CH334R RESET#),
    full hub->port mapping, RP2040 no-connect pins, and R10-R13 roles.
    Netlist is now fully verified — ready for KiCad generation.
2026-06-25 Pull exact LCSC part symbols + footprints + 3D models via easyeda2kicad
    21/23 BOM parts imported into kicad/lib/openrb.{kicad_sym,pretty,3dshapes}
    straight from the EasyEDA/LCSC library by part number, so symbols and
    footprints match the parts actually ordered. TYPE-C (C165948) and the 12MHz
    crystal (C9002) pending an API rate-limit cooldown; MIDI jack (CP-2350, no
    LCSC id) needs a substitute/custom symbol.
2026-06-25 Generate editable KiCad schematic from verified netlist
    gen_sch.py builds openrb/openrb.kicad_sch by placing all 56 components (exact
    LCSC symbols + footprints) and labeling every pin per RECONSTRUCTION.md. A flat,
    net-label-driven schematic: opens in KiCad, footprints linked via project lib
    tables, connectivity verified against the spec by kicad-cli netlist export.
    Includes exported PDF + netlist and a README.
2026-06-25 Generate editable KiCad schematic from verified netlist + LCSC symbols
    Schematic now loads in KiCad 10, exports a netlist, and renders. All 56
    components placed with their exact LCSC/EasyEDA symbols (pulled by part
    number) and matching footprints; connectivity via net labels at true pin
    endpoints. Spot-checked critical nets against RECONSTRUCTION.md (USB device/
    host, hub->ports, MIDI, reset/boot, power rails) — all match. Added project
    sym/fp-lib-tables. Remaining ERC items are pin-type-strictness warnings
    (PWR_FLAG vs bidirectional), not wiring errors.
2026-06-25 Split schematic into 3 pages grouped by subsection
    Hierarchical project: root sheet + USB / MCU / MIDI child pages, mirroring
    the original schematic's organization. Components grouped under titled
    subsections (USB-C/ESD, hub, host ports, RP2040, decoupling, flash, osc,
    regulator, reset, prog, status LEDs, MIDI). Cross-sheet connectivity via
    global labels; netlist verified identical to the single-sheet version
    (56 components, 78 nets, same node membership). gen_multi.py regenerates it.
2026-06-25 Add recovered rev 0.2 Gerbers as a layout reference
    Stage the recovered production Gerbers + Excellon drills under
    kicad/reference/gerbers/ and add headless top/bottom renders (gerbonara)
    for visual reference while re-laying the board. README documents the one
    GUI step (GerbView -> Export to Pcbnew) for a live .kicad_pcb tracing
    overlay, since KiCad has no headless Gerber->PCB path.
2026-06-25 Fix SWD1/UART header pinout (GND is the middle/first pin)
    Hardware-verified by attaching a CMSIS-DAP SWD probe: both RP2040 cores
    enumerate only with GND on SWD1 pin 2 and UART pin 1. Corrects the earlier
    reconstruction which had GND on pin 3. Updated the generator, regenerated
    the schematic/netlist/PDF, and the spec.
